jjCSE113NMT/dsp-neutron-spectrometer/README.md

# dsp-neutron-spectrometer

A place to keep all our material related to our senior design project.
