jjCSE113NMT/dsp-neutron-spectrometer/Useful_links.txt

Helium tube sheet: https://www.bakerhughesds.com/sites/g/files/cozyhq596/files/2019-06/reuter_stokes_helium_3_detector_formation_evaluation_english.pdf

HV supplies: https://www.hvmtech.com/

Overleaf project: https://www.overleaf.com/5288895847gmcdnccjdjpx
