jjCSE113NMT/dsp-neutron-spectrometer/PCB/parts/STX-3500-3NTR_rA7.IGS

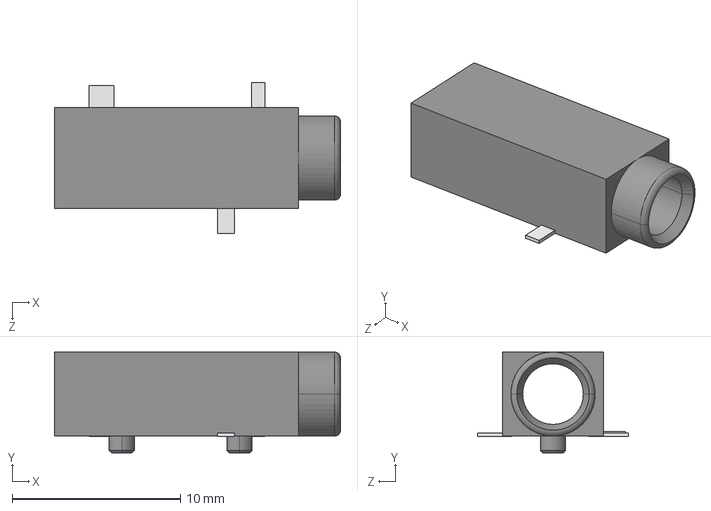
[picture p1: CAD file, 2023-04-10]
PCB/parts/STX-3500-3NTR_rA7.IGS
17.0 x 6.00 x 9.00 mm
