jjCSE113NMT/dsp-neutron-spectrometer/PCB/parts/TNPN_2N2222AUB_OPT.step

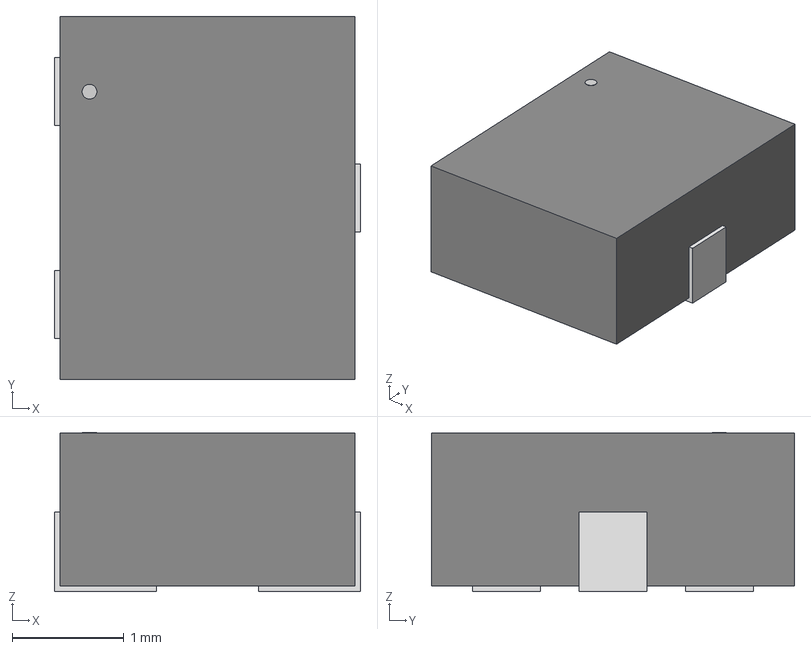
[picture p2: CAD file, 2023-03-15]
PCB/parts/TNPN_2N2222AUB_OPT.step
2.74 x 3.25 x 1.43 mm
