jjCSE113NMT/dsp-neutron-spectrometer/PCB/parts/3361p001.stp

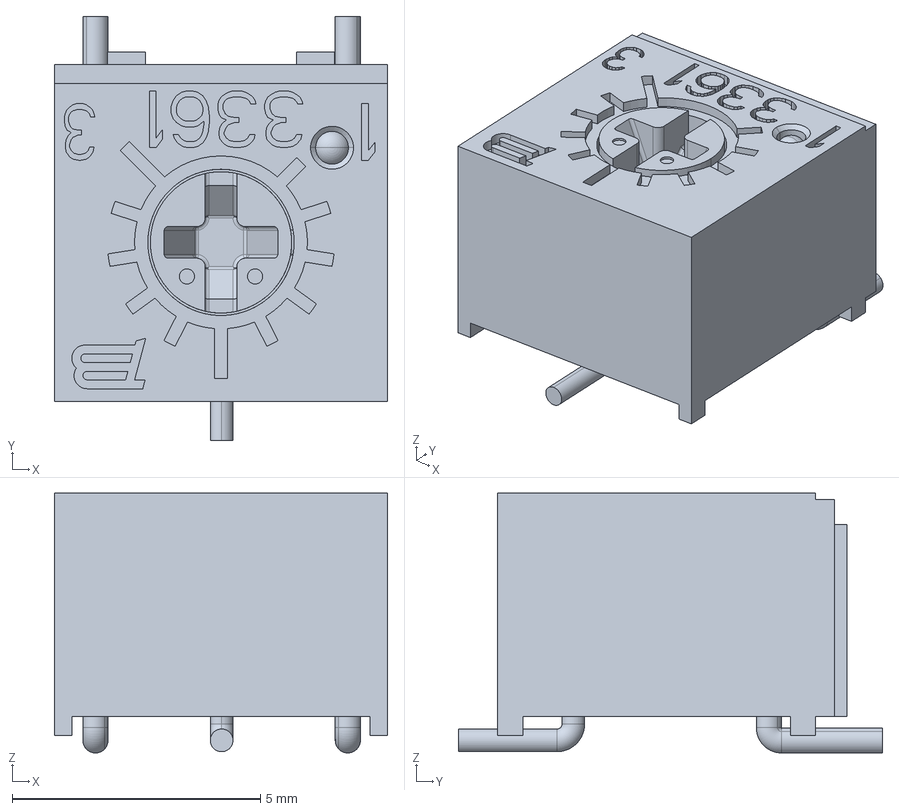
[picture p3: CAD file, 2023-04-10]
PCB/parts/3361p001.stp
6.71 x 8.53 x 5.23 mm
