jjCSE113NMT/dsp-neutron-spectrometer/LTspice/analog_section.asc

B2: bv; V=3.3 * u(time - 500u) * u(-time + 500u + 10u)
C1: cap; 200n
C2: cap; 200n
C3: cap; 200n
C4: cap; 10p
C5: cap; 10p
C6: cap; 10p
C7: cap; 10n
C8: cap; 1.5n
C9: cap; 1.5n
C10: cap; 1.5n
C11: cap; 82p
C12: cap; 82p
C13: cap; 10p
C14: cap; 10p
C15: cap; 10p
C16: cap; 10p
C17: cap; 10p
C18: cap; 10p
C19: cap; 82p
C20: cap; 82p
HV: voltage; 1.5k
IT: current; EXP(0 965.663n 10u 0 0 621.335n)
Q1: npn; 2N2222
R1: res; 47Meg
R2: res; 10k
R3: res; 5.9k
R4: res; 10Meg
R5: res; 1k
R6: res; 50
R7: res; 1k
R8: res; 10k
R9: res; 10k
R10: res; 10k
R11: res; 10k
R12: res; 1k
R13: res; 10k
R14: res; 10k
R15: res; 1Meg
R16: res; 1k
R17: res; 1k
R19: res; 1k
R20: res; 1Meg
R21: res; 1Meg
R22: res; 1Meg
R23: res; 1Meg
R24: res; 1k
R25: res; 1.5k
R26: res; 10Meg
R27: res; 10Meg
T1: tline; Td=1n Z0=50
T2: tline; Td=1n Z0=50
T3: tline; Td=1n Z0=50
U1: opamp2; OPAx350
U2: opamp2; OPAx350
U3: NE555
U5: opamp2; OPAx350
U6: opamp2; OPAx350
V2: voltage; -5
V3: voltage; 5
Named nets: 0, Vhv, -5V, 5V, Vpamp, Vo
.tran 100m
Calculated to be ~600[fC]
.inc ./external_components/OPAx350.LIB
