jjCSE113NMT/dsp-neutron-spectrometer/PCB/Panoptes.kicad_pcb

## KiCad design PCB/Panoptes.kicad_pcb (2023-04-17)

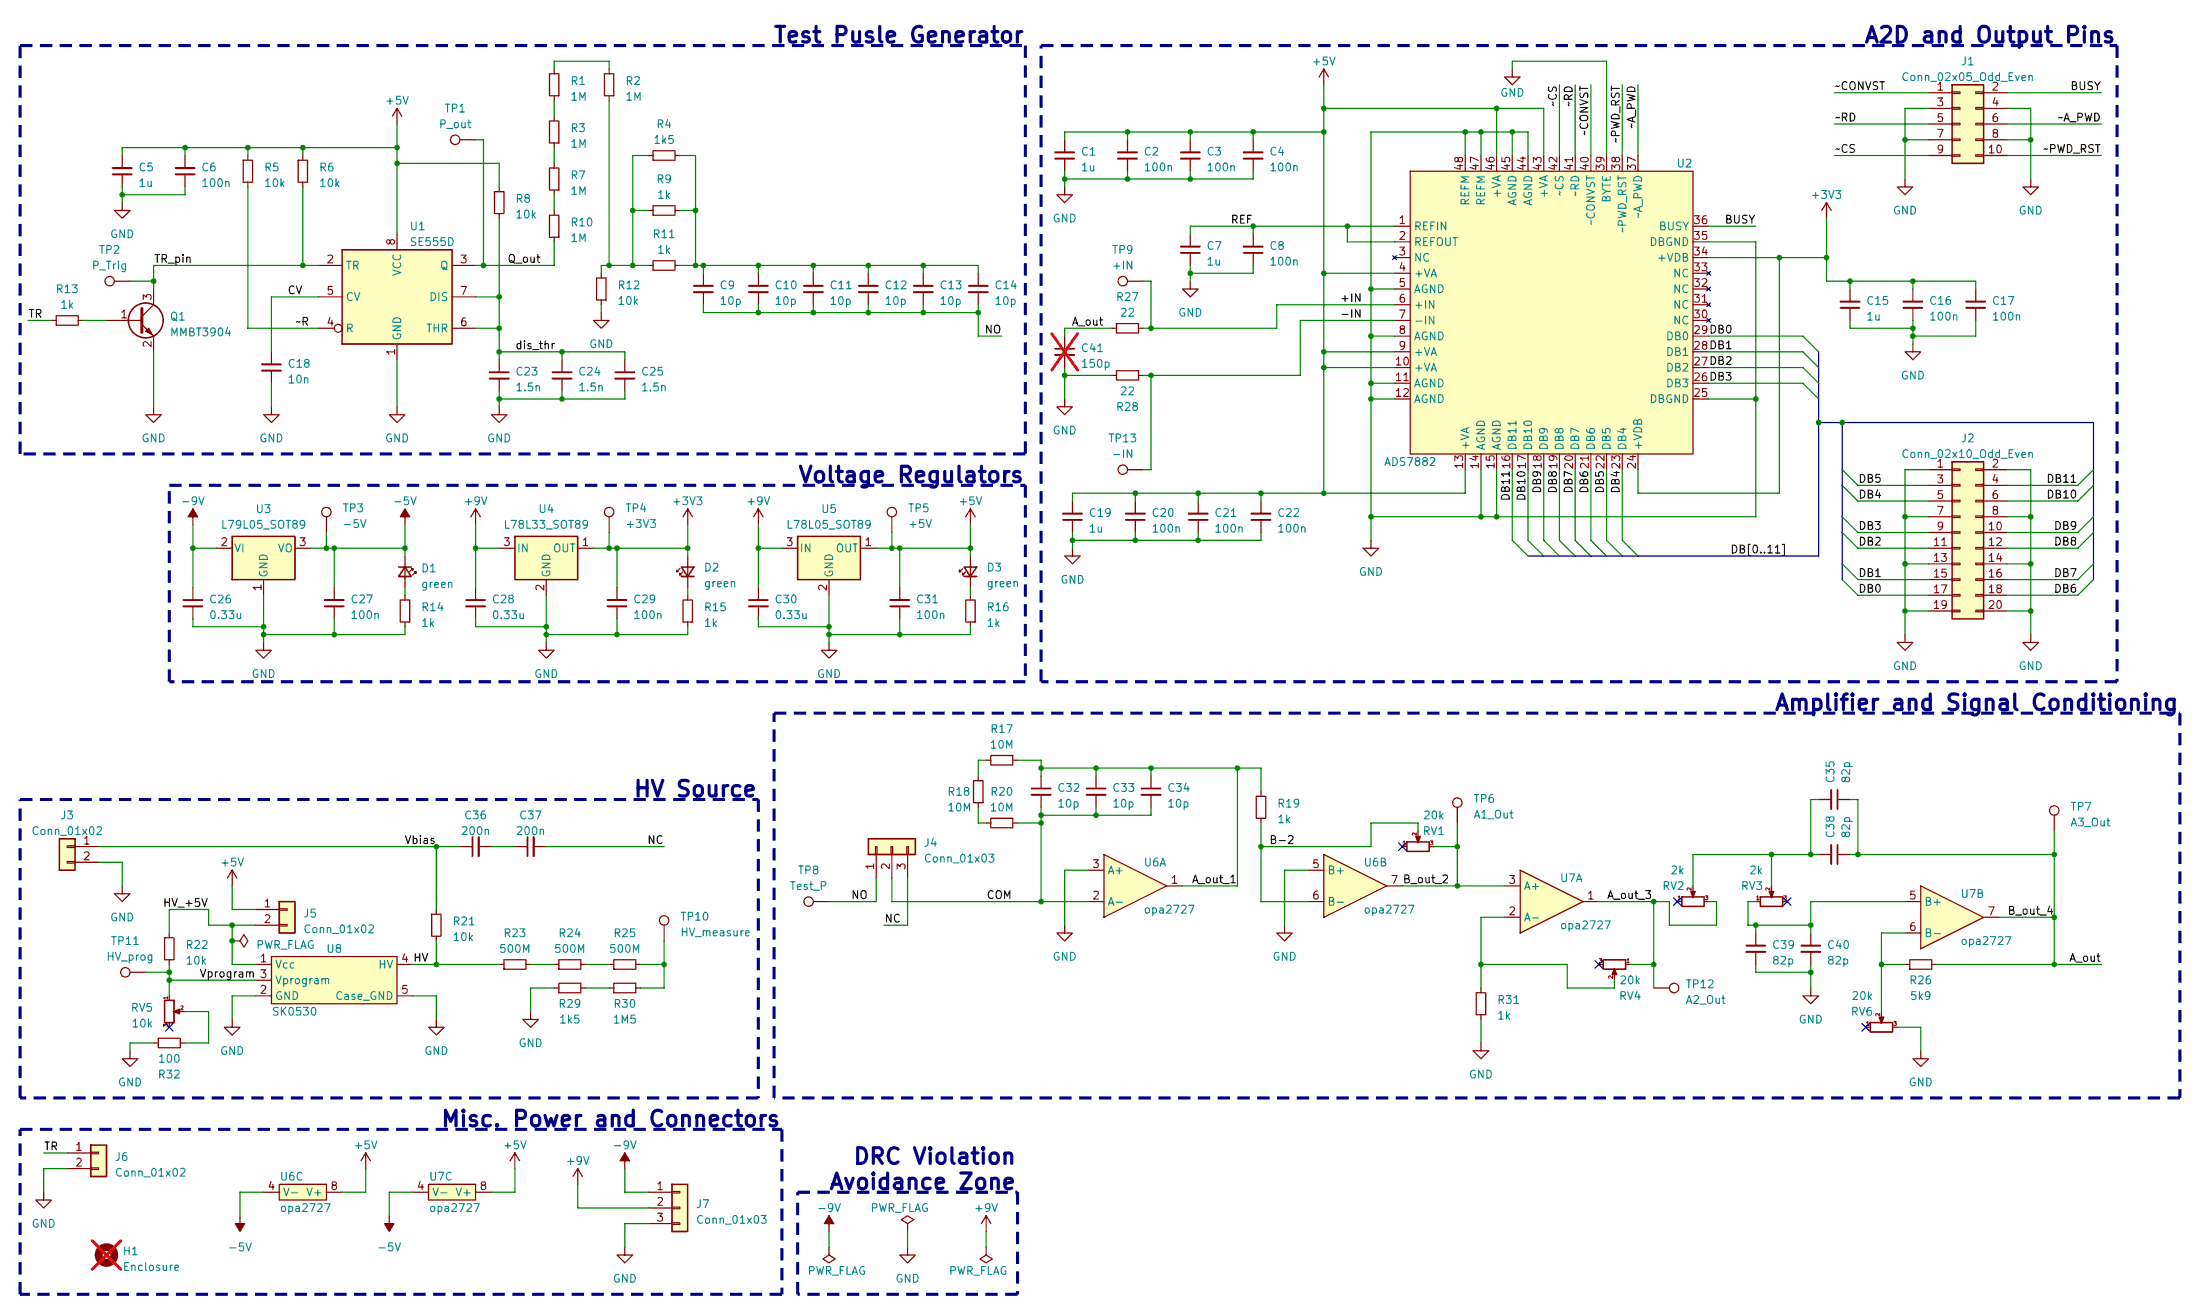
[picture p4: schematic Panoptes.kicad_sch, Panoptes Analog Board Schematic]

Parts:
C1, C5, C7, C15, C19: 1u; C_1206_3216Metric; MPN CL31B105KAHNNNE
C2, C3, C4, C6, C8, C16, C17, C20, C21, C22, C27, C29, C31: 100n; C_1206_3216Metric; MPN CL31B104KBCNNNC
C9, C10, C11, C12, C13, C14, C32, C33, C34: 10p; C_1206_3216Metric; MPN C1206C100F1HACAUTO
C18: 10n; C_1206_3216Metric; MPN C1206C103JARAC7800
C23, C24, C25: 1.5n; C_1206_3216Metric; MPN CC1206FRNPO9BN152
C26, C28, C30: 0.33u; C_1206_3216Metric; MPN CL31B334KBFNNNE
C35, C38, C39, C40: 82p; C_1206_3216Metric; MPN CC1206JRNPO9BN820
C36, C37: 200n; C_Disc_D10.5mm_W5.0mm_P7.50mm; MPN CK45-B3FD221KYGNA
C41: 150p; C_0603_1608Metric; not fitted
D1, D2, D3: green; LED_0805_2012Metric; MPN 150080VS75000
H1: Enclosure; n/a; MPN 1455N1201RD; not fitted
J1: Conn_02x05_Odd_Even; PinSocket_2x05_P2.54mm_Horizontal; MPN SFH11-PBPC-D05-RA-BK
J2: Conn_02x10_Odd_Even; PinSocket_2x10_P2.54mm_Horizontal; MPN SFH11-PBPC-D10-RA-BK
J3: Conn_01x02; tube pigtail; MPN n/a
J4: Conn_01x03; PinHeader_1x03_P2.54mm_Vertical; MPN n/a
J5: Conn_01x02; PinHeader_1x02_P2.54mm_Vertical; MPN n/a
J6: Conn_01x02; PinSocket_1x02_P2.54mm_Horizontal; MPN PPTC021LGBN-RC
J7: Conn_01x03; STX-3500-3NTR; MPN STX-3500-3NTR
Q1: MMBT3904; SOT-23-3; MPN MMBT3904-TP
R1, R2, R3, R7, R10: 1M; R_1206_3216Metric; MPN RMCF1206FT1M00
R4, R29: 1k5; R_1206_3216Metric; MPN RMCF1206FT1K50
R5, R6, R8, R12, R21, R22: 10k; R_1206_3216Metric; MPN RMCF1206FT10K0
R9, R11, R13, R14, R15, R16, R19, R31: 1k; R_1206_3216Metric; MPN RMCF1206FT1K00
R17, R18, R20: 10M; R_1206_3216Metric; MPN RMCF1206FT10M0
R23, R24, R25: 500M; R_Axial_DIN0207_L6.3mm_D2.5mm_P7.62mm_Horizontal; MPN HVA05FA500M
R26: 5k9; R_1206_3216Metric; MPN CRCW12065K90FKEA
R27, R28: 22; R_1206_3216Metric; MPN RMCF1206FT22R0
R30: 1M5; R_1206_3216Metric; MPN RC1206FR-071M5L
R32: 100; R_1206_3216Metric; MPN RMCF1206FG100R
RV1, RV4, RV6: 20k; Bourns 3361P; MPN 3361P-1-203GLF
RV2, RV3: 2k; Bourns 3361P; MPN 3361P-1-202GLF
RV5: 10k; Bourns 3361P; MPN 3361P-1-103GLF
TP1: P_out; PinHeader_1x01_P2.54mm_Vertical; MPN n/a
TP2: P_Trig; PinHeader_1x01_P2.54mm_Vertical; MPN n/a
TP3: -5V; PinHeader_1x01_P2.54mm_Vertical; MPN n/a
TP4: +3V3; PinHeader_1x01_P2.54mm_Vertical; MPN n/a
TP5: +5V; PinHeader_1x01_P2.54mm_Vertical; MPN n/a
TP6: A1_Out; PinHeader_1x01_P2.54mm_Vertical; MPN n/a
TP7: A3_Out; PinHeader_1x01_P2.54mm_Vertical; MPN n/a
TP8: Test_P; PinHeader_1x01_P2.54mm_Vertical; MPN n/a
TP9: +IN; PinHeader_1x01_P2.54mm_Vertical; MPN n/a
TP10: HV_measure; TestPoint_Pad_D1.0mm; MPN n/a
TP11: HV_prog; TestPoint_Pad_D1.0mm; MPN n/a
TP12: A2_Out; PinHeader_1x01_P2.54mm_Vertical; MPN n/a
TP13: -IN; PinHeader_1x01_P2.54mm_Vertical; MPN n/a
U1: SE555D; SOIC-8_3.9x4.9mm_P1.27mm; MPN SE555DR
U2: ADS7882; TQFP-48_7x7mm_P0.5mm; MPN ADS7882IPFBT
U3: L79L05_SOT89; SOT-89-3; MPN L79L05ACUTR
U4: L78L33_SOT89; SOT-89-3; MPN L78L33ACUTR
U5: L78L05_SOT89; SOT-89-3; MPN L78L05ACUTR
U6, U7: opa2727; DFN-8-1EP_3x3mm_P0.65mm_EP1.55x2.4mm; MPN OPA2727AIDRBT
U8: SK0530; MPN SK0530

Connections:
+3V3: C15.2, C16.2, C17.2, C29.2, D2.2 (A), TP4.1, U2.24 (+VDB), U2.34 (+VDB), U4.1 (OUT)
+5V: C1.2, C2.2, C3.2, C4.2, C5.2, C6.2, C19.2, C20.2, C21.2, C22.2, C31.2, D3.2 (A), J5.1, R5.1, R6.1, R8.1, TP5.1, U1.8 (VCC), U2.4 (+VA), U2.9 (+VA), U2.10 (+VA), U2.13 (+VA), U2.43 (+VA), U2.46 (+VA), U5.1 (OUT), U6.8 (V+), U7.8 (V+)
+9V: C28.1, C30.1, J7.2, U4.3 (IN), U5.3 (IN)
-5V: C27.2, D1.1 (K), TP3.1, U3.3 (VO), U6.4 (V-), U7.4 (V-)
-9V: C26.1, J7.1, U3.2 (VI)
/+IN: R27.1, TP9.1, U2.6 (+IN)
/-IN: R28.1, TP13.1, U2.7 (-IN)
/A_out: C35.1, C38.1, C41.1, R26.2, R27.2, TP7.1, U7.7
/A_out_1: C32.1, C33.1, C34.1, R17.1, R19.1, U6.1
/A_out_3: RV2.3, RV4.1, TP12.1, U7.1
/B-2: R19.2, RV1.2, U6.6 (B-)
/BUSY: J1.2, U2.36 (BUSY)
/B_out_2: RV1.3, TP6.1, U6.7, U7.3 (A+)
/COM: C32.2, C33.2, C34.2, J4.2, R20.1, U6.2 (A-)
/CV: C18.1, U1.5 (CV)
/DB0: J2.17, U2.29 (DB0)
/DB1: J2.15, U2.28 (DB1)
/DB2: J2.11, U2.27 (DB2)
/DB3: J2.9, U2.26 (DB3)
/DB4: J2.5, U2.23 (DB4)
/DB5: J2.3, U2.22 (DB5)
/DB6: J2.18, U2.21 (DB6)
/DB7: J2.16, U2.20 (DB7)
/DB8: J2.12, U2.19 (DB8)
/DB9: J2.10, U2.18 (DB9)
/DB10: J2.6, U2.17 (DB10)
/DB11: J2.4, U2.16 (DB11)
/HV: R21.2, R23.1, U8.4 (HV)
/HV_+5V: J5.2, R22.1, U8.1 (Vcc)
/NC: C37.2, J4.3
/NO: C9.2, C10.2, C11.2, C12.2, C13.2, C14.2, J4.1, TP8.1
/Q_out: R10.1, TP1.1, U1.3 (Q)
/REF: C7.2, C8.2, U2.1 (REFIN), U2.2 (REFOUT)
/TR: J6.1, R13.1
/TR_pin: Q1.3 (C), R6.2, TP2.1, U1.2 (TR)
/Vbias: C36.1, J3.1, R21.1
/Vprogram: R22.2, RV5.1, TP11.1, U8.3 (Vprogram)
/dis_thr: C23.1, C24.1, C25.1, R8.2, U1.6 (THR), U1.7 (DIS)
/~A_PWD: J1.6, U2.37 (~A_PWD)
/~CONVST: J1.1, U2.40 (~CONVST)
/~CS: J1.9, U2.42 (~CS)
/~PWD_RST: J1.10, U2.38 (~PWD_RST)
/~R: R5.2, U1.4 (R)
/~RD: J1.5, U2.41 (~RD)
GND: C1.1, C2.1, C3.1, C4.1, C5.1, C6.1, C7.1, C8.1, C15.1, C16.1, C17.1, C18.2, C19.1, C20.1, C21.1, C22.1, C23.2, C24.2, C25.2, C26.2, C27.1, C28.2, C29.1, C30.2, C31.1, C39.2, C40.2, C41.2, J1.3, J1.4, J1.7, J1.8, J2.1, J2.2, J2.7, J2.8, J2.13, J2.14, J2.19, J2.20, J3.2, J6.2, J7.3, Q1.2 (E), R12.1, R14.1, R15.1, R16.1, R28.2, R29.1, R31.1, R32.1, RV6.3, U1.1 (GND), U2.5 (AGND), U2.8 (AGND), U2.11 (AGND), U2.12 (AGND), U2.14 (AGND), U2.15 (AGND), U2.25 (DBGND), U2.35 (DBGND), U2.39 (BYTE), U2.44 (AGND), U2.45 (AGND), U2.47 (REFM), U2.48 (REFM), U3.1 (GND), U4.2 (GND), U5.2 (GND), U6.3 (A+), U6.5 (B+), U8.2 (GND), U8.5 (Case_GND)
unnamed: C9.1, C10.1, C11.1, C12.1, C13.1, C14.1, R4.2, R9.2, R11.2
unnamed: C35.2, C38.2, RV2.2, RV3.2
unnamed: C36.2, C37.1
unnamed: D1.2 (A), R14.2
unnamed: D2.1 (K), R15.2
unnamed: D3.1 (K), R16.2
unnamed: Q1.1 (B), R13.2
unnamed: R1.1, R3.2
unnamed: R1.2, R2.2
unnamed: R3.1, R7.2
unnamed: R7.1, R10.2
unnamed: R2.1, R4.1, R9.1, R11.1, R12.2
unnamed: R17.2, R18.2
unnamed: R18.1, R20.2
unnamed: R23.2, R24.1
unnamed: R24.2, R25.1
unnamed: R25.2, R30.2, TP10.1
unnamed: R29.2, R30.1
unnamed: R32.2, RV5.2
unnamed: R31.2, RV4.2, U7.2 (A-)
unnamed: C39.1, C40.1, RV3.1, U7.5 (B+)
unnamed: R26.1, RV6.2, U7.6 (B-)

Notes on the sheet:
Voltage Regulators
Test Pusle Generator
DRC Violation Avoidance Zone
Misc. Power and Connectors
Amplifier and Signal Conditioning
HV Source
A2D and Output Pins

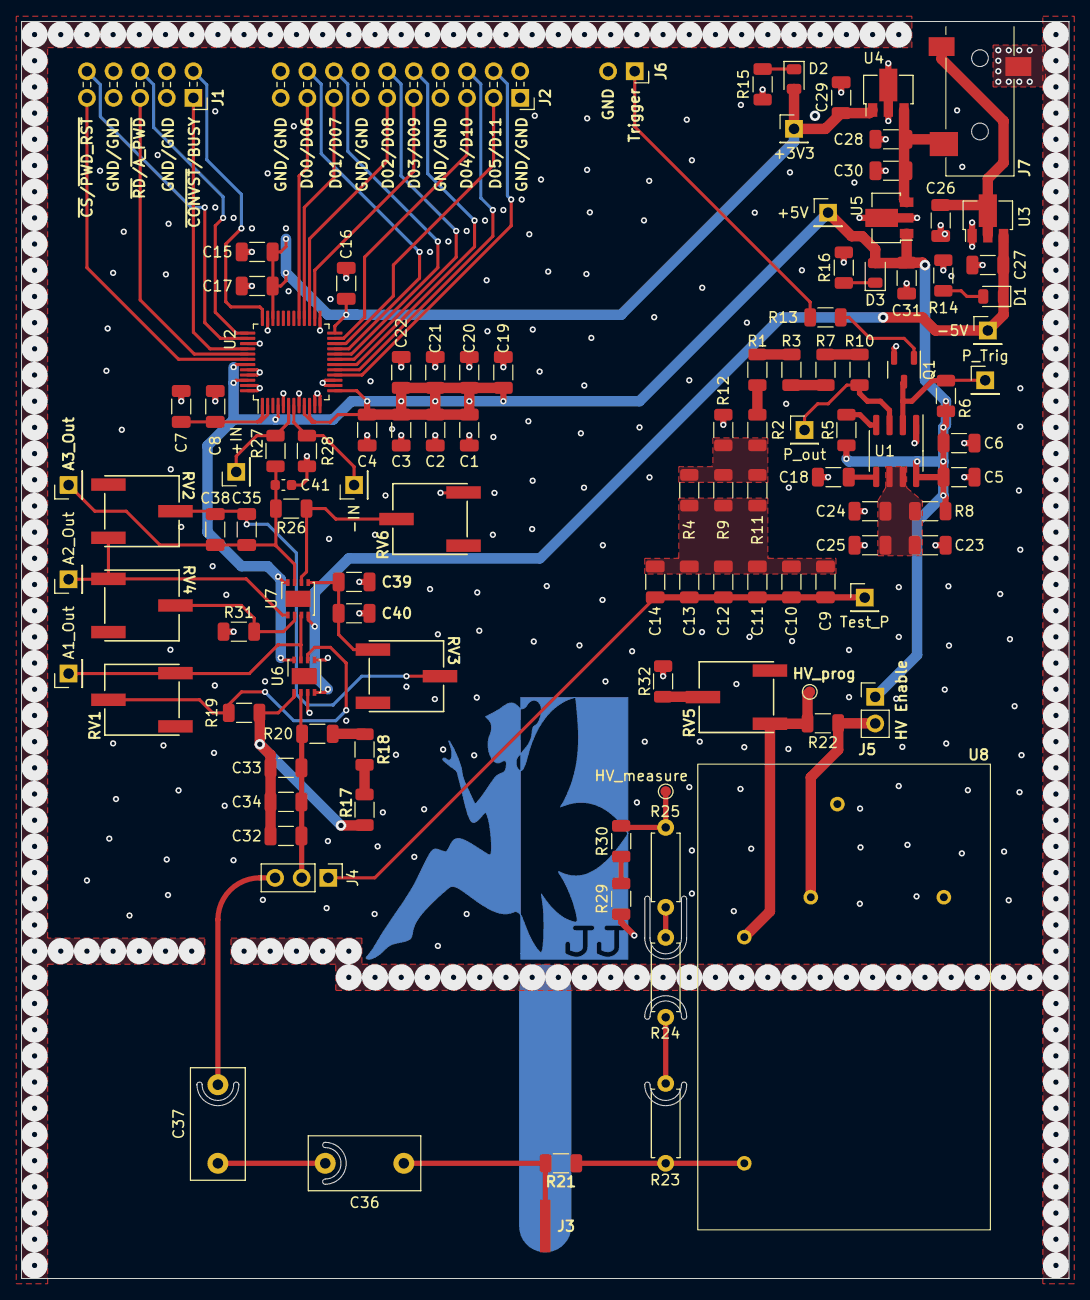
[picture p5: board Panoptes.kicad_pcb from above]

Board: 4 copper layers, 100.0 x 120.0 mm, 111 parts (0 on the bottom side), 67 nets.
