jjCSE113NMT/dsp-neutron-spectrometer/microcontroller_code/Core/Src/main.c

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
/* Includes ------------------------------------------------------------------*/
#include "main.h"
#include "cmsis_os.h"
#include "app_touchgfx.h"

/* USER CODE BEGIN Includes */
#include "../Components/nt35510/nt35510.h"
#include "stm32469i_discovery_sdram.h"
#include "stm32469i_discovery_qspi.h"
/* USER CODE END Includes */

/* USER CODE BEGIN PD */
#define N 2000		//input buffer size 1ms worth of adc reads

/* PARAMETERS BEGIN */
//#define TAU 1000.0 // RC time constant of input signal's decay. Set to zero to skip decay tail correction.
#define TAU 0.0		//TEST ONly REEEEEEEEE!!!!!!!!!!!!!!!!!!!!!!!!!!!!!!!!!!!!!!!!!!!!!!!!
#define RISETIME 80 // Rise Time of Trapezoid; Must be greater than input signal's rise time. Larger means more noise filtering.
#define FLATTIME 40 // Duration of Trapezoidal flat top. Allows a longer Moving Average Filter.
#define MOVETIME 40 // Points for Moving Average Filter; Must be less than or equal to RISETIME or it will attenuate the peaks.

#define PEAKTHRESH_LOWER 200 // Lower threshold for Peak Detection. Peaks below this value will be ignored by the PeakDetector.
#define PEAKTHRESH_UPPER 5000 // Upper threshold for Peak Detection. Peaks above this value will be ignored by the PeakDetector.
/* PARAMETERS END */

/* Circular Buffer Sizes DO NOT ADJUST DIRECTLY */
#define Na 2
#define Nb (FLATTIME + 2*RISETIME)
#define Nc MOVETIME
#define Np 3

/* DISPLAY */
#define LCD_ORIENTATION_LANDSCAPE 0x01
/* USER CODE END PD */

CRC_HandleTypeDef hcrc;

DMA2D_HandleTypeDef hdma2d;

DSI_HandleTypeDef hdsi;

I2C_HandleTypeDef hi2c1;

LTDC_HandleTypeDef hltdc;

QSPI_HandleTypeDef hqspi;

TIM_HandleTypeDef htim12;
TIM_HandleTypeDef htim14;

SDRAM_HandleTypeDef hsdram1;

/* Definitions for defaultTask */
osThreadId_t defaultTaskHandle;
const osThreadAttr_t defaultTask_attributes = {
  .name = "defaultTask",
  .stack_size = 128 * 4,
  .priority = (osPriority_t) osPriorityNormal,
};
/* Definitions for TouchGFXTask */
osThreadId_t TouchGFXTaskHandle;
const osThreadAttr_t TouchGFXTask_attributes = {
  .name = "TouchGFXTask",
  .stack_size = 4096 * 4,
  .priority = (osPriority_t) osPriorityNormal,
};
/* USER CODE BEGIN PV */
/* Definitions for dspTask */
osThreadId_t dspTaskHandle;
const osThreadAttr_t dspTask_attributes = {
  .name = "dspTask",
  .stack_size = 2056 * 4,
  .priority = (osPriority_t) osPriorityNormal,
};

//__IO uint16_t adcBuffer[N] = {0,0,0,0,0,0,0,0,0,0,0,0,0,0,0,0,0,0,0,0,0,0,0,0,0,0,0,0,0,0,0,0,0,0,0,0,0,0,0,0,0,0,0,0,0,0,0,0,0,0,0,0,0,0,0,0,0,0,0,0,0,0,0,0,0,0,0,0,0,0,0,0,0,0,0,0,0,0,0,0,0,0,0,0,0,0,0,0,0,0,0,0,112,225,337,450,562,675,787,900,1012,1125,1237,1350,1462,1575,1687,1800,1800,1800,1800,1800,1800,1800,1800,1800,1800,1800,1800,1800,1800,1800,1800,1800,1800,1800,1800,1800,1800,1800,1800,1800,1800,1800,1800,1800,1800,1800,1800,1800,1800,1800,1800,1800,1800,1800,1800,1800,1800,1800,1800,1800,1800,1800,1800,1800,1800,1800,1800,1800,1800,1800,1800,1800,1800,1800,1800,1800,1800,1800,1800,1800,1800,1800,1800,1800,1800,1800,1800,1800,1800,1800,1800,1800,1800,1800,1800,1800,1800,1800,1800,1800,1800,1800,1800,1800,1800,1800,1800,1800,1800,1800,1800,1800,1800,1800,1800,1800,1800,1800,1800,1800,1800,1800,1800,1800,1800,1800,1800,1800,1800,1800,1800,1800,1800,1800,1800,1800,1800,1800,1800,1800,1800,1800,1800,1800,1800,1800,1800,1800,1800,1800,1800,1800,1800,1800,1800,1800,1800,1800,1800,1800,1800,1800,1800,1800,1800,1800,1800,1800,1800,1800,1800,1800,1800,1800,1800,1800,1800,1800,1800,1800,1800,1800,1800,1800,1800,1800,1800,1800,1800,1800,1800,1800,1800,1800,1800,1800,1800,1800,1800,1800,1800,1800,1800,1800,1800,1800,1800,1800,1800,1800,1800,1800,1800,1800,1800,1800,1800,1800,1800,1800,1800,1800,1800,1800,1800,1800,1800,1800,1800,1800,1800,1800,1800,1800,1800,1800,1800,1800,1800,1800,1800,1800,1800,1800,1800,1800,1800,1800,1800,1800,1800,1800,1800,1800,1800,1800,1800,1800,18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
00,4000,4000,4000,4000,4000,4000,4000,4000,4000,4000,4000,4000,4000,4000,4000,4000,4000,4000,4000,4000,4000,4000,4000,4000,4000,4000,4000,4000,4000,4000,4000,4000,4000,4000,4000,4000,4000,4000,4000,4000,4000,4000,4000,4000,4000,4000,4000,4000,4000,4000,4000,4000,4000,4000,4000,4000,4000,4000,4000,4000,4000,4000,4000,4000,4000,4000,4000,4000,4000,4000,4000,4000,4000,4000,4000,4000,4000,4000,4000,4000,4000,4000,4000,4000,4000,4000,4000,4000,4000,4000,4000,4000,4000,4000,4000,4000,4000,4000,4000,4000,4000,4000,4000,4000,4000,4000,4000,4000,4000,4000,4000,4000,4000,4000,4000,4000,4000,4000,4000,4000,4000,4000,4000,4000,4000,4000,4000,4000,4000,4000,4000,4000,4000,4000,4000,4000,4000,4000,4000,4000,4000,4000,4000,4000,4000,4000,4000,4000,4000};     //adcBuffer to hold past adc reads
__IO uint16_t adcBuffer[N] = {0};	//adcBuffer to hold past adc reads
__IO uint16_t n;  						//index to increment adcBuffer write
__IO uint16_t pulseHeight;					//variable that passes pulse height to model
__IO uint16_t adcBufferFull;
volatile uint16_t adcRead;

/* Circular Buffer Indexes */
volatile unsigned na = 0; // Filter #1/#2
volatile unsigned nb = 0; // Filter #3
volatile unsigned nc = 0; // Filter #4
volatile unsigned np = 0; // Peak Detector

/* Circular Buffers */
volatile double V1[Na] = {0}; // Circular Buffer #1 - Raw Input
volatile double V2[Na] = {0}; // Circular Buffer #2 - Tail Correcting
volatile double V3[Nb] = {0}; // Circular Buffer #3 - Corrected Input to Shaper
volatile double V4[Nc] = {0}; // Circular Buffer #4 - Shaped Output to Moving Average
volatile double Vp[Np] = {0}; // Peak Detector Circular Buffer

/* Hack to typecast #define directives to not be ints for division */
static double dbTau = TAU;
static double dbRiseTime = RISETIME;
static double dbMoveTime = MOVETIME;

/* Tracker to prevent double reads of peaks */
volatile int PeakCooldown = 0;
/* USER CODE END PV */

void SystemClock_Config(void);
static void MX_GPIO_Init(void);
static void MX_CRC_Init(void);
static void MX_DMA2D_Init(void);
static void MX_DSIHOST_DSI_Init(void);
static void MX_FMC_Init(void);
static void MX_LTDC_Init(void);
static void MX_QUADSPI_Init(void);
static void MX_TIM14_Init(void);
static void MX_I2C1_Init(void);
static void MX_TIM12_Init(void);
void StartDefaultTask(void *argument);
extern void TouchGFX_Task(void *argument);

/* USER CODE BEGIN PFP */
void dsp_Task(void *argument);

/* Function Declarations */
double SmoothedTrapezoidalFilter(double Vin);
double PeakDetector(double Vin);
void CleanBuffers(void);
/* USER CODE END PFP */

/**
  * @brief  The application entry point.
  * @retval int
  */
int main(void)
{
  /* MCU Configuration--------------------------------------------------------*/

  /* Reset of all peripherals, Initializes the Flash interface and the Systick. */
  HAL_Init();

  /* Configure the system clock */
  SystemClock_Config();

  /* Initialize all configured peripherals */
  MX_GPIO_Init();
  MX_CRC_Init();
  MX_DMA2D_Init();
  MX_DSIHOST_DSI_Init();
  MX_FMC_Init();
  MX_LTDC_Init();
  MX_QUADSPI_Init();
  MX_TIM14_Init();
  MX_I2C1_Init();
  MX_TIM12_Init();
  MX_TouchGFX_Init();
  /* Call PreOsInit function */
  MX_TouchGFX_PreOSInit();
  /* USER CODE BEGIN 2 */
  /* creation of defaultTask */
  /* creation of TouchGFXTask */
  TouchGFXTaskHandle = osThreadNew(TouchGFX_Task, NULL, &TouchGFXTask_attributes);
  /*creation of dspTask*/
  dspTaskHandle = osThreadNew(dsp_Task, NULL, &dspTask_attributes);
  /* USER CODE END 2 */

  /* Init scheduler */
  osKernelInitialize();
/* USER CODE BEGIN Header */
/**
  ******************************************************************************
  * @file           : main.c
  * @brief          : Main program body
  ******************************************************************************
  * @attention
  *
  * <h2><center>&copy; Copyright (c) 2020 STMicroelectronics.
  * All rights reserved.</center></h2>
  *
  * This software component is licensed by ST under Ultimate Liberty license
  * SLA0044, the "License"; You may not use this file except in compliance with
  * the License. You may obtain a copy of the License at:
  *                             www.st.com/SLA0044
  *
  ******************************************************************************
  */
/* USER CODE END Header */
/**
* @}
*/
/**
* @}
*/

  /* Start scheduler */
  osKernelStart();

  /* We should never get here as control is now taken by the scheduler */
  /* Infinite loop */
  /* USER CODE BEGIN WHILE */
  while (1)
  {
    /* USER CODE END WHILE */

    /* USER CODE BEGIN 3 */
  }
  /* USER CODE END 3 */
}

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
/* USER CODE BEGIN 4 */
/*This is effectively our main function. Current osThread alternates between touchgfxtask and this one*/
void dsp_Task(void *argument)
{
	unsigned i;
	double Vin;
	double Vout;
	double Vpeak;

	n=0;
	adcRead = 0;
	adcBufferFull = 0;

	HAL_TIM_PWM_Start(&htim14, TIM_CHANNEL_1);	//api to start timer14
	//HAL_TIM_PWM_Start(&htim12, TIM_CHANNEL_1);	//api to start timer12  !!!delete this later
	HAL_NVIC_EnableIRQ(EXTI15_10_IRQn);	//enable busy_pin exint !always comment out the other after MX generate
  for(;;)
  {
	  if(adcBufferFull==1)//when adcBuffer is full execute
	  {
		  /*Begin actual DSP stuff*/
		  /* Process batch of data */
		  	for (i = 0; i < N; i++)
		  	{
		  		Vin = adcBuffer[i];
		  		Vout = SmoothedTrapezoidalFilter(Vin); // Feed input samples into filter
		  		Vpeak = PeakDetector(Vout); // Feed filter output into peak detector
		  		// Single line: Vpeak = PeakDetector(SmoothedTrapezoidalFilter(INPUT[i]));

		  		if (Vpeak > 0)
		  		{
		  			// Add output code here
		  			// Note: there _could_ be multiple peaks in a single batch
		  			pulseHeight = Vpeak;
		  			osDelay(22);	//wait exactly this amount of time after updating pulseHeight to give model a chance
		  		}
		  	}

		  	/* Cleanup Buffers to not contaminate next processing batch */
		  	CleanBuffers();
		  /*End actual DSP stuff*/

		  n=0; //reset adcBuffer write index
		  adcBufferFull = 0;
		  HAL_NVIC_EnableIRQ(EXTI15_10_IRQn);	//reenable interrupts from adc
	  }
      //osDelay(1);
  }
}

// EXTI Line10 External Interrupt ISR Handler CallBackFun
//this executes every time BUSY has a rising edge signaling a new ADC value is ready to read
/*non-circular adcBuffer filled by interrupt
DSP filter task will read this non-circular adcBuffer when it has a chance to run
filter will read this adcBuffer as-if it were real-time data being input
(put adcBuffer values into own circular adcBuffer then do dsp algorithms)*/
void HAL_GPIO_EXTI_Callback(uint16_t GPIO_Pin)
{
    if(GPIO_Pin == BUSY_Pin) // If The INT Source Is EXTI Line[15:10] (PB12 Pin)
    {

    	//left shift bits of pins and bitwise or them together into one int
    	adcRead=
    							HAL_GPIO_ReadPin(GPIOB, D12_0_Pin)
								 |(HAL_GPIO_ReadPin(GPIOA, D12_1_Pin)<<1)
								 |(HAL_GPIO_ReadPin(GPIOB, D12_2_Pin)<<2)
								 |(HAL_GPIO_ReadPin(GPIOA, D12_3_Pin)<<3)
								 |(HAL_GPIO_ReadPin(GPIOC, D12_4_Pin)<<4)
								 |(HAL_GPIO_ReadPin(GPIOC, D12_5_Pin)<<5)
								 |(HAL_GPIO_ReadPin(GPIOC, D12_6_Pin)<<6)
								 |(HAL_GPIO_ReadPin(GPIOB, D12_7_Pin)<<7)
								 |(HAL_GPIO_ReadPin(GPIOG, D12_8_Pin)<<8)
								 |(HAL_GPIO_ReadPin(GPIOG, D12_9_Pin)<<9)
								 |(HAL_GPIO_ReadPin(GPIOG, D12_10_Pin)<<10)
								 |(HAL_GPIO_ReadPin(GPIOC, D12_11_Pin)<<11);

    	if(n>=N)
    	{
    		adcBufferFull = 1;
    		HAL_NVIC_DisableIRQ(EXTI15_10_IRQn); //disable interrupt when adcBuffer is full
    	}
    	else
    	{
			adcBuffer[n] = adcRead;	//write temp adc value to buffer
			n++;
    	}

    }
}

/* SmoothedTrapezoidalFilter
 * Takes in voltage samples and shapes them into smoothed-top trapezoids.
 * Input is first pole-zero corrected (if TAU > 0),
 *	then sent to a trapezoidal shaping filter,
 *	then sent to a moving average filter.
 * Input is expected to be either a square step signal (TAU = 0)
 *	or tail pulses with decay time constant TAU.
 * Shaping time is determined by RISETIME and FLATTIME.
 * Smoothing is determined by MOVETIME.
 * Vin: Input voltage sample.
 * Returns the shaped output voltage of the filter.
 */
double SmoothedTrapezoidalFilter(double Vin) {
	unsigned k;
	double Vav_t1;
	double Vav_t2;
	double Vav_t3;

	V1[na] = Vin; // Input into Circular Buffer

	if (dbTau > 0) {
		/* Correct for Decay; turn tail pulse into square steps */
		V2[na] = (V2[(na + 1) % Na] + V1[na] - V1[(na + 1) % Na] * (1 - 1 / dbTau));
		V3[nb] = V2[na];
	} else {
		/* Decay rate not specified; skip */
		V3[nb] = V1[na];
	}

	/* Trapezoid Shaping Filter */
	Vav_t1 = 0.0;
	Vav_t2 = 0.0;
	// Difference of two moving averages, separated by FLATTIME samples
	for (k = 0; k < RISETIME; k++) {
		Vav_t1 = Vav_t1 + V3[(nb + k) % Nb]; // Moving Average #1
		Vav_t2 = Vav_t2 + V3[(RISETIME + FLATTIME + nb + k) % Nb]; // Moving Average #2
	}
	V4[nc] = (Vav_t2 - Vav_t1) / dbRiseTime; // Difference of Moving Averages

	/* Moving Average Filter (low-pass smoothing) */
	Vav_t3 = 0.0;
	for (k = 0; k < MOVETIME; k++) {
		Vav_t3 = Vav_t3 + V4[(nc + k) % Nc];
	}
	Vav_t3 = Vav_t3 / dbMoveTime;

	/* Increment Buffer Indexes */
	if (++na >= Na) {
		na = 0;
	}
	if (++nb >= Nb) {
		nb = 0;
	}
	if (++nc >= Nc) {
		nc = 0;
	}

	return Vav_t3;
}

/* PeakDetector
 * Takes in voltage samples and processes them to find peak values.
 * Rejects all peaks below PEAKTHRESH_LOWER and above PEAKTHRESH_UPPER thresholds.
 * Rejects duplicate peaks found within FLATTIME samples.
 * Vin: Input voltage sample.
 * Returns the peak voltage value if a valid peak is detected.
 * Returns 0 if no valid peak is detected.
 */
double PeakDetector(double Vin) {
	double Vpeak = 0.0;
	double Vprev;
	double Vcurr;
	double Vnext;

	Vp[np] = Vin; // Input into Circular Buffer

	if (PeakCooldown > 0) {
		/* Recently detected a peak; ignore subsequent input for now */
		PeakCooldown--;
	} else {
		/* Check for a valid peak */
		// Circular buffer magic
		Vprev = Vp[(np + 1) % Np]; // Equivalent to Vp[np - 2]
		Vcurr = Vp[(np + 2) % Np]; // Equivalent to Vp[np - 1]
		Vnext = Vp[np];

		if ((Vcurr >= Vprev) && (Vcurr >= Vnext) && // If Vcurr is a "high point"...
			(Vcurr >= PEAKTHRESH_LOWER) && (Vcurr <= PEAKTHRESH_UPPER)) { // and within thresholds...
			Vpeak = Vcurr; // Register as a peak value
			PeakCooldown = FLATTIME; // Prevent double-counting noisy peaks
		}
	}

	/* Increment Buffer Index */
	if (++np >= Np) {
		np = 0;
	}

	return Vpeak;
}

/* CleanBuffers
 * Sets all elements of the circular buffers used by
 *	SmoothedTrapezoidalFilter() and PeakDetector() to 0.0
 */
void CleanBuffers(void) {
	unsigned i;

	for (i = 0; i < Na; i++) {
		V1[i] = 0.0;
		V2[i] = 0.0;
	}
	for (i = 0; i < Nb; i++) {
		V3[i] = 0.0;
	}
	for (i = 0; i < Nc; i++) {
		V4[i] = 0.0;
	}
	for (i = 0; i < Np; i++) {
		Vp[i] = 0.0;
	}

	na = 0;
	nb = 0;
	nc = 0;
	np = 0;
}
/* USER CODE END 4 */

/* USER CODE BEGIN Header_StartDefaultTask */
/**
  * @brief  Function implementing the defaultTask thread.
  * @param  argument: Not used
  * @retval None
  */
/* USER CODE END Header_StartDefaultTask */
void StartDefaultTask(void *argument)
{
  /* USER CODE BEGIN 5 */
  /* Infinite loop */
  for(;;)
  {
    osDelay(1);
  }
  /* USER CODE END 5 */
}

/**
  * @brief  Period elapsed callback in non blocking mode
  * @note   This function is called  when TIM6 interrupt took place, inside
  * HAL_TIM_IRQHandler(). It makes a direct call to HAL_IncTick() to increment
  * a global variable "uwTick" used as application time base.
  * @param  htim : TIM handle
  * @retval None
  */
void HAL_TIM_PeriodElapsedCallback(TIM_HandleTypeDef *htim)
{
  if (htim->Instance == TIM6) {
    HAL_IncTick();
  }
}

/**
  * @brief  This function is executed in case of error occurrence.
  * @retval None
  */
void Error_Handler(void)
{
  /* USER CODE BEGIN Error_Handler_Debug */
  /* User can add his own implementation to report the HAL error return state */

  /* USER CODE END Error_Handler_Debug */
}

#ifdef  USE_FULL_ASSERT
/**
  * @brief  Reports the name of the source file and the source line number
  *         where the assert_param error has occurred.
  * @param  file: pointer to the source file name
  * @param  line: assert_param error line source number
  * @retval None
  */
void assert_failed(uint8_t *file, uint32_t line)
{
  /* USER CODE BEGIN 6 */
  /* User can add his own implementation to report the file name and line number,
     tex: printf("Wrong parameters value: file %s on line %d\r\n", file, line) */
  /* USER CODE END 6 */
}
#endif /* USE_FULL_ASSERT */
