jjCSE113NMT/dsp-neutron-spectrometer/microcontroller_code/Core/Inc/input.h

#define G 1500
static double INPUT[G] = {
-0.3658182924498795,-0.7567250113552825,-0.1087008192936706,-0.5301201702287681,1.458349369587476,0.3613467133356985,1.15836404289467,0.05211111319651363,-0.08645743485905155,0.349118688443429,0.8670552188846975,0.8822058326231152,0.5676836668093541,-0.5526825442573258,-1.395951629854583,0.3959333402717218,-0.9992387433649428,0.4676934095018855,0.4353069947011013,0.8936429449929952,0.3827677460960754,0.4745297177309414,-0.3354599960773968,0.7535597663394578,0.6736218086029979,1.116640647039743,0.9664954268471587,0.6593821571041895,0.312806749375478,1.441230188120453,0.06649736391105088,1.115454112068145,-0.005675503087719025,-0.0434396411943766,-0.6374647220151077,1.077404864505613,-0.3547393128898304,0.1031076525010511,0.261703890435029,-1.159736140731445,-0.05275084515467809,-0.1879855917986609,0.6576854425084137,1.130291345669453,-0.3056916469906165,-1.307326553143159,-0.6220664641603632,0.3132100370531534,-0.6083803912651587,-0.3714883547458937,-1.191180186015396,-0.827440650283243,0.4184351869701365,0.5869214630912306,-0.01043997455086165,-0.584058001389468,-0.2640879362596033,-1.407516036976246,-0.1801127246834647,0.5618921421760739,-1.486551203289031,-0.1485631586749819,0.7621085373033053,-0.6279249665226777,-1.328456264769367,0.9869706975623829,0.05871519477097331,1.052458148222395,-0.4802566824933261,1.390861434043524,0.5371373645093004,-0.3292322422115723,0.1551695183446514,-0.09156730751252806,0.0128230397124931,-1.144230954816613,0.4043660397892139,-1.033864547763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
,1.371909496028533,3.488554946480055,3.255832169280166,2.964988648099441,3.200579665637353,2.186478913210907,3.899549134358043,2.681488824757558,1.783184864854638,3.355688965668526,2.288767392678602

};
