jjCSE113NMT/dsp-neutron-spectrometer/(commit log)

2022-10-05 added some links and the tube 'datasheet'
2023-03-15 Hopefully the last commit needed to fix this issue.
    [Panoptes-B_Cu.gbr, Panoptes-B_Mask.gbr, Panoptes-B_Silkscreen.gbr, Panoptes-Edge_Cuts.gbr, Panoptes-F_Cu.gbr, Panoptes-F_Mask.gbr, Panoptes-F_Silkscreen.gbr, Panoptes-In1_Cu.gbr]
2023-04-08 start of rev.3
    [Panoptes.csv, Panoptes.kicad_pcb, Panoptes.kicad_sch]
2023-04-10 All signals routed
    [3361p001.stp, Panoptes.kicad_pcb, Panoptes.kicad_sch, STX-3500-3NTR_rA7.IGS]
2023-04-13 V3 completed
    [Panoptes-B_Cu.gbr, Panoptes-B_Mask.gbr, Panoptes-B_Silkscreen.gbr, Panoptes-Edge_Cuts.gbr, Panoptes-F_Cu.gbr, Panoptes-F_Mask.gbr, Panoptes-F_Silkscreen.gbr, Panoptes-In1_Cu.gbr]
2023-04-17 Added DNP cap to ADC input.
    [Panoptes.kicad_pcb, Panoptes.kicad_sch]
2023-05-07 Added MCU code for stm32
